HumbertoBM2/AnalogAndDigitalPID/DGallery/datoslimpios.png

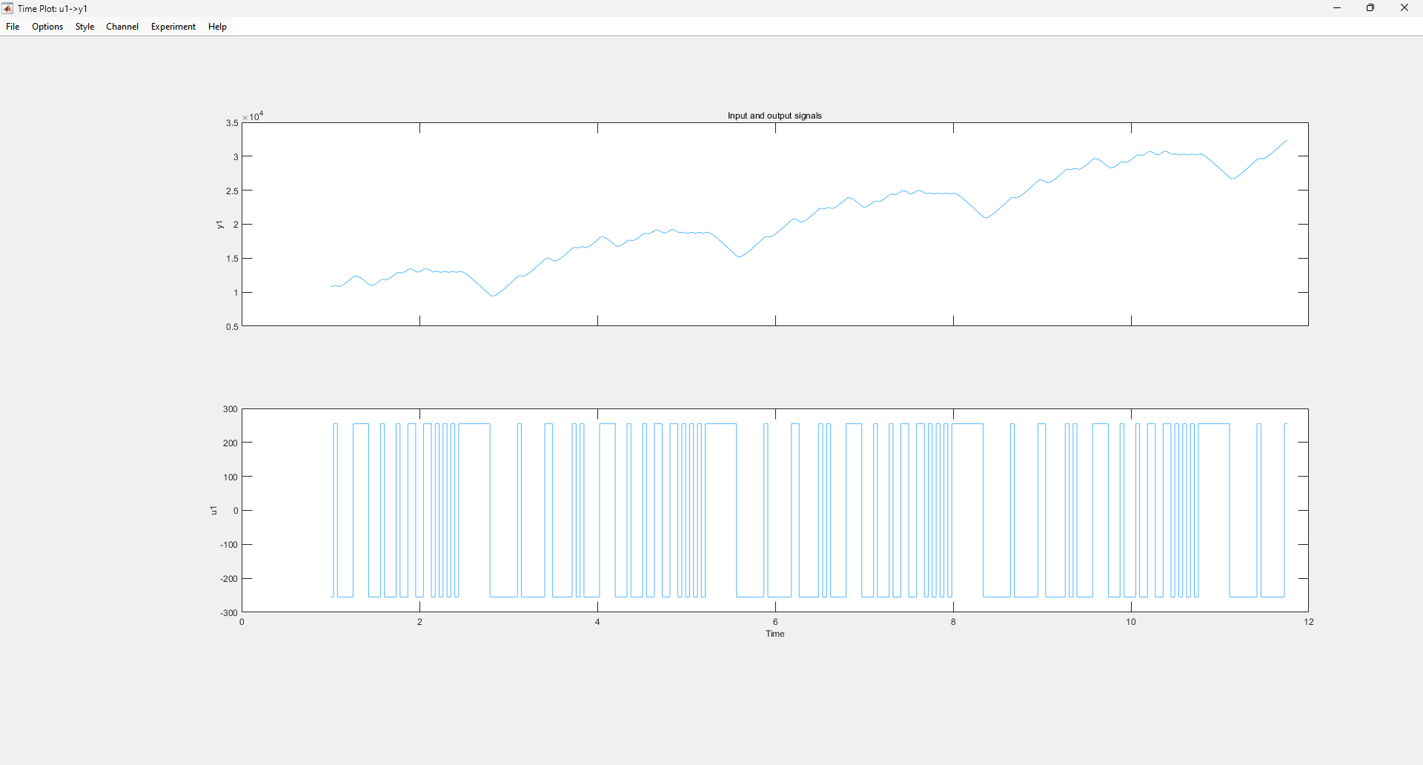
DGallery/datoslimpios.png
