HumbertoBM2/AnalogAndDigitalPID/DGallery/graficafsimulink.png

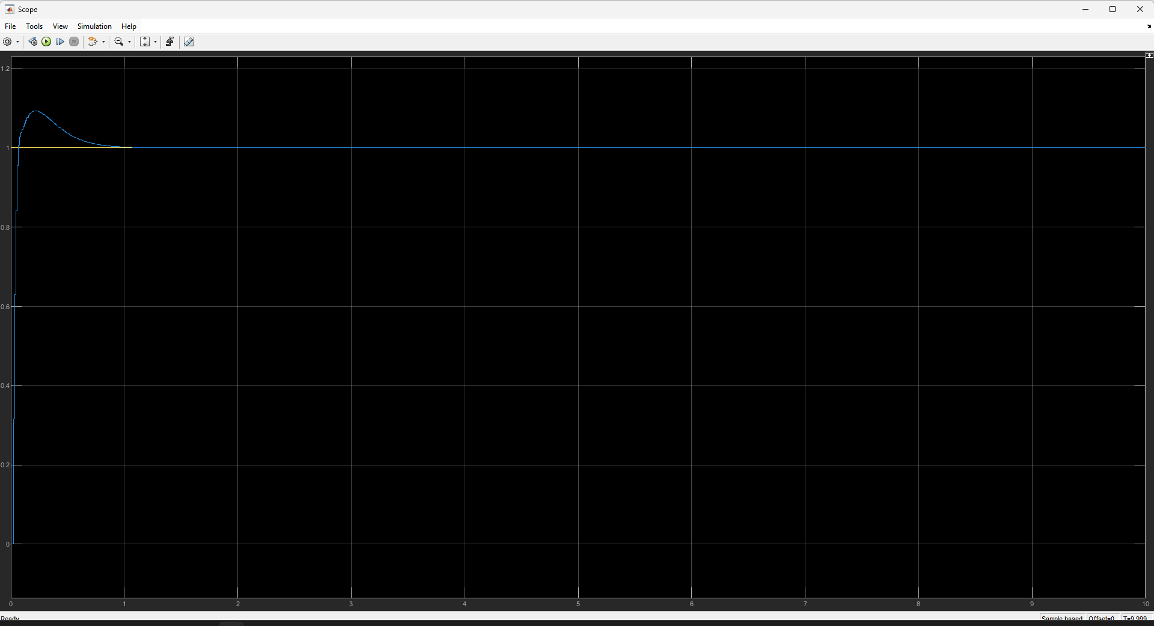
DGallery/graficafsimulink.png
