HumbertoBM2/AnalogAndDigitalPID/DGallery/pidsimulink.png

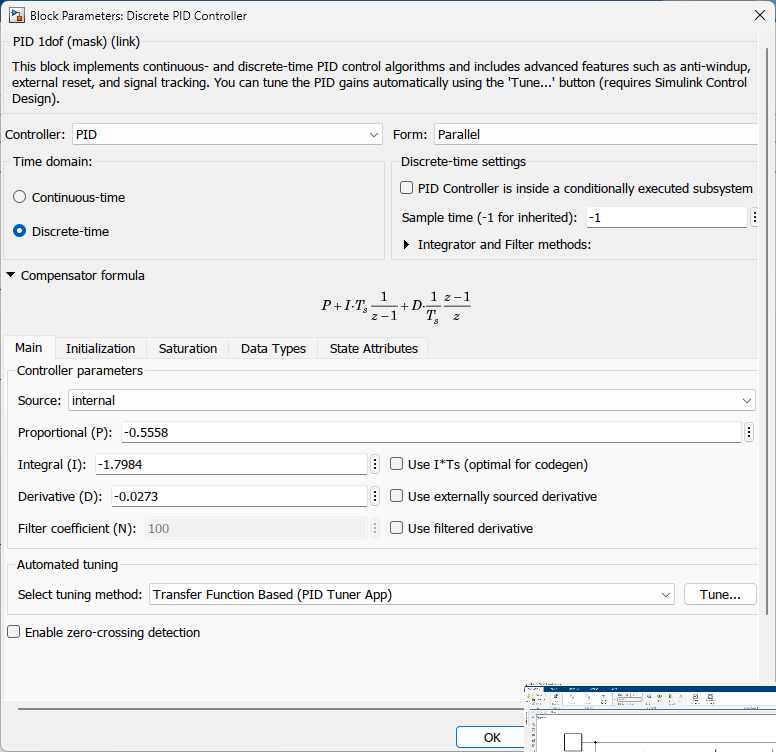
DGallery/pidsimulink.png
