HumbertoBM2/AnalogAndDigitalPID/DGallery/pitunerbueno.png

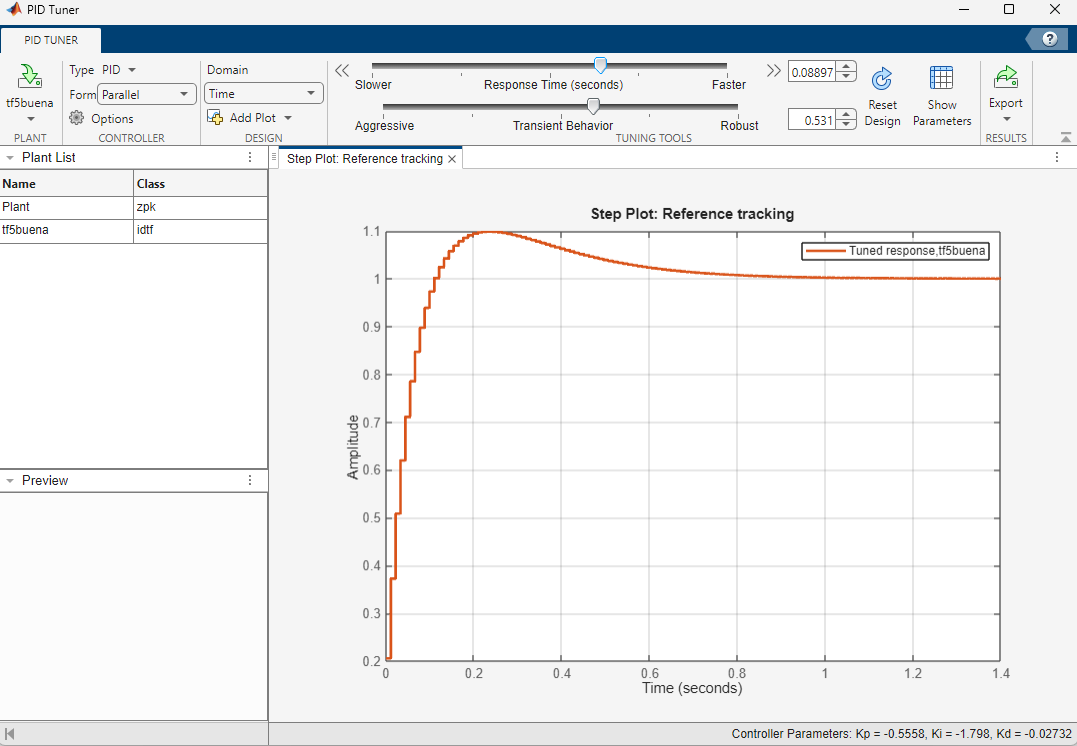
DGallery/pitunerbueno.png
