HumbertoBM2/AnalogAndDigitalPID/DGallery/ss1.jpg

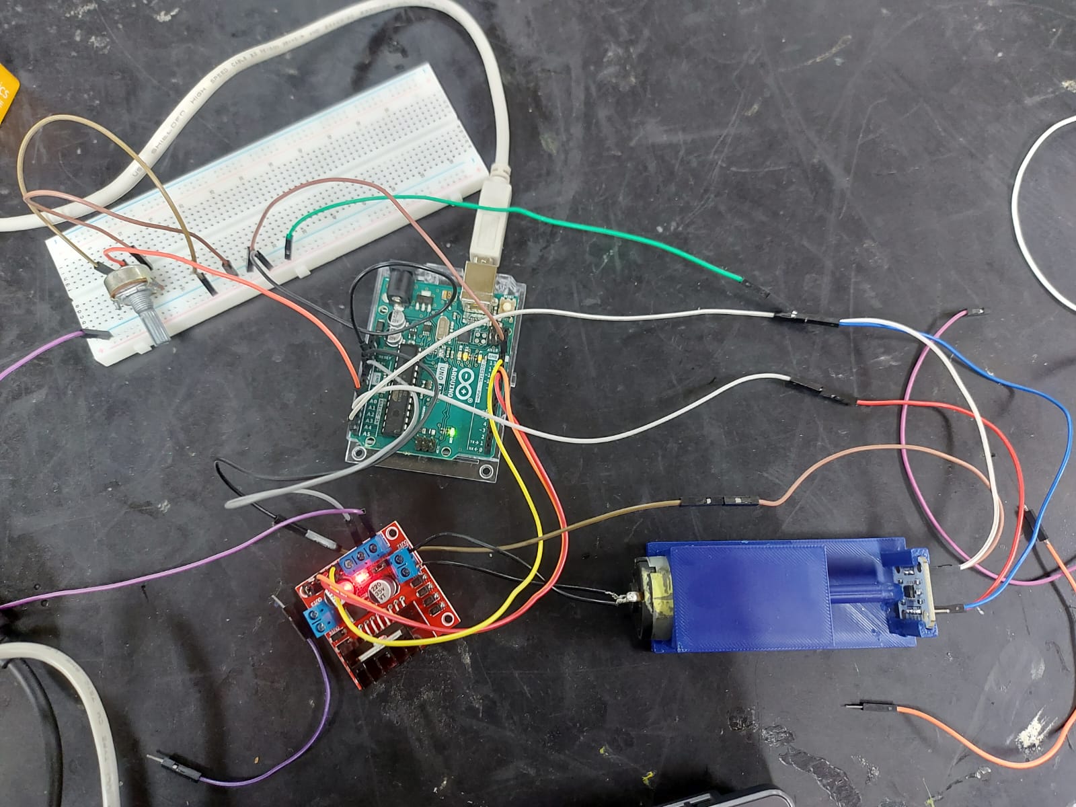
DGallery/ss1.jpg
