HumbertoBM2/AnalogAndDigitalPID/DGallery/ss2.jpg

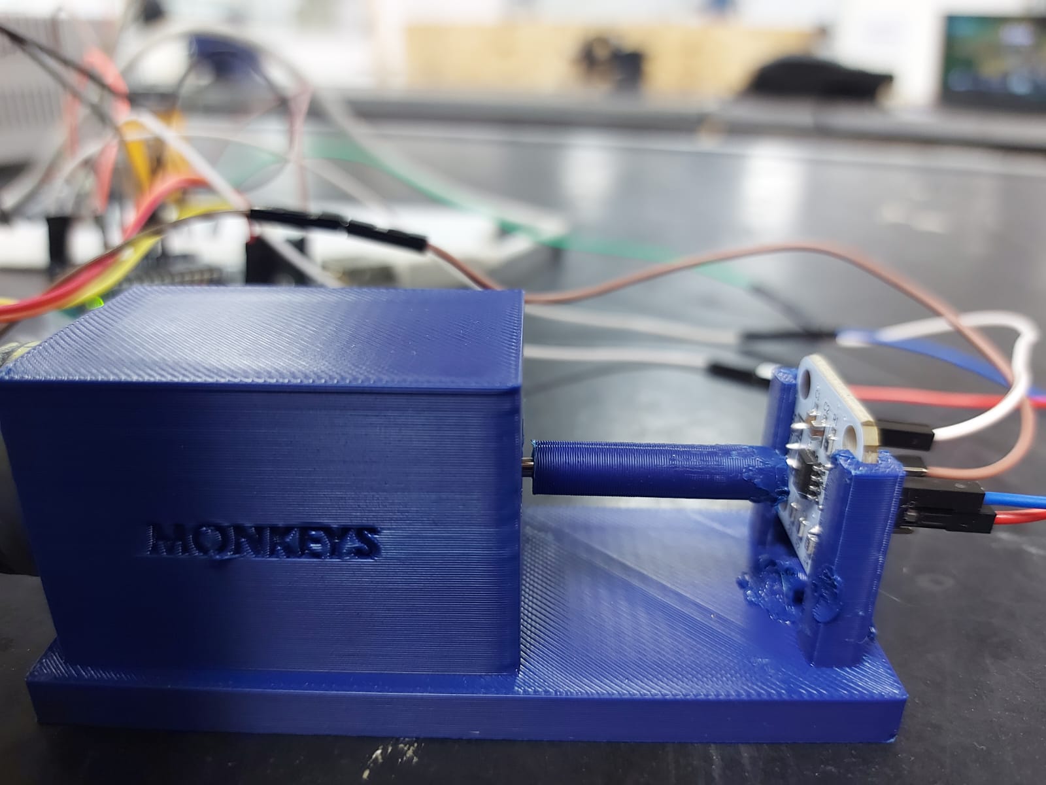
DGallery/ss2.jpg
