HumbertoBM2/AnalogAndDigitalPID/DGallery/ss3.png

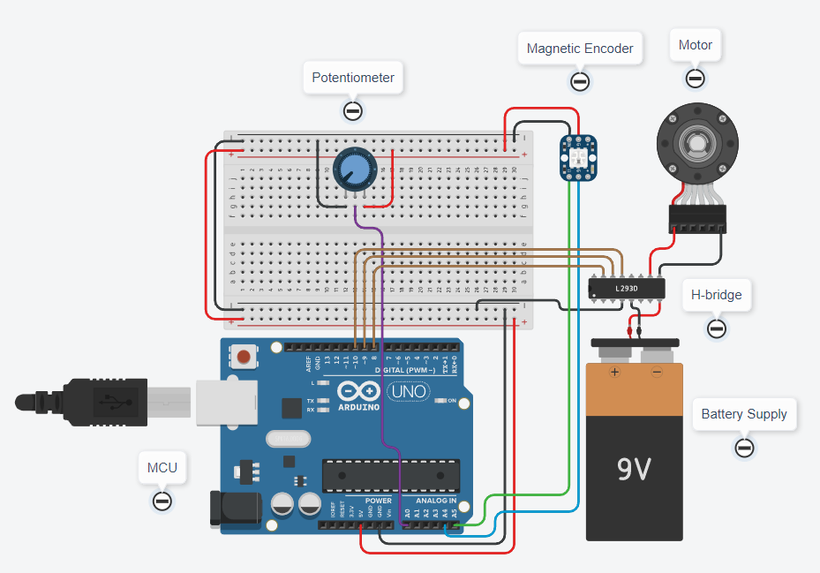
DGallery/ss3.png
