HumbertoBM2/AnalogAndDigitalPID/DGallery/ss11.jpg

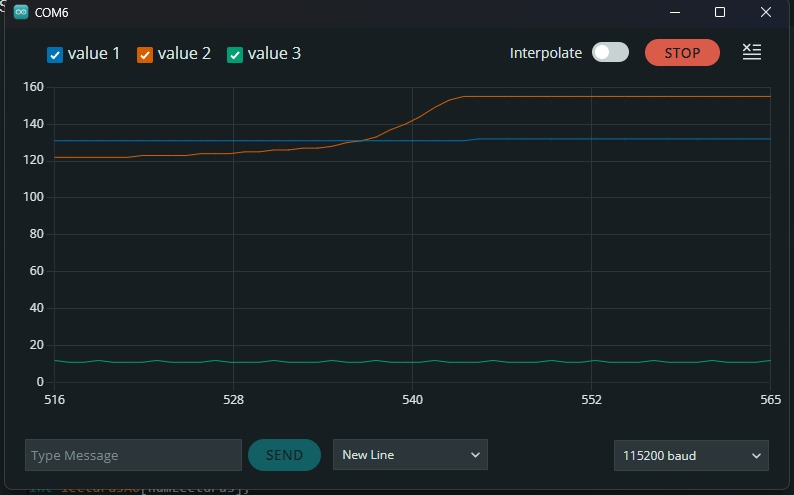
DGallery/ss11.jpg
