HumbertoBM2/AnalogAndDigitalPID/DGallery/systemident.png

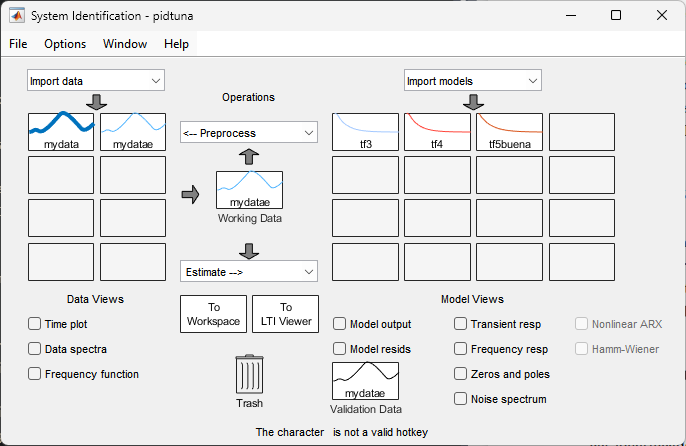
DGallery/systemident.png
