HumbertoBM2/AnalogAndDigitalPID/DGallery/tf5graf.png

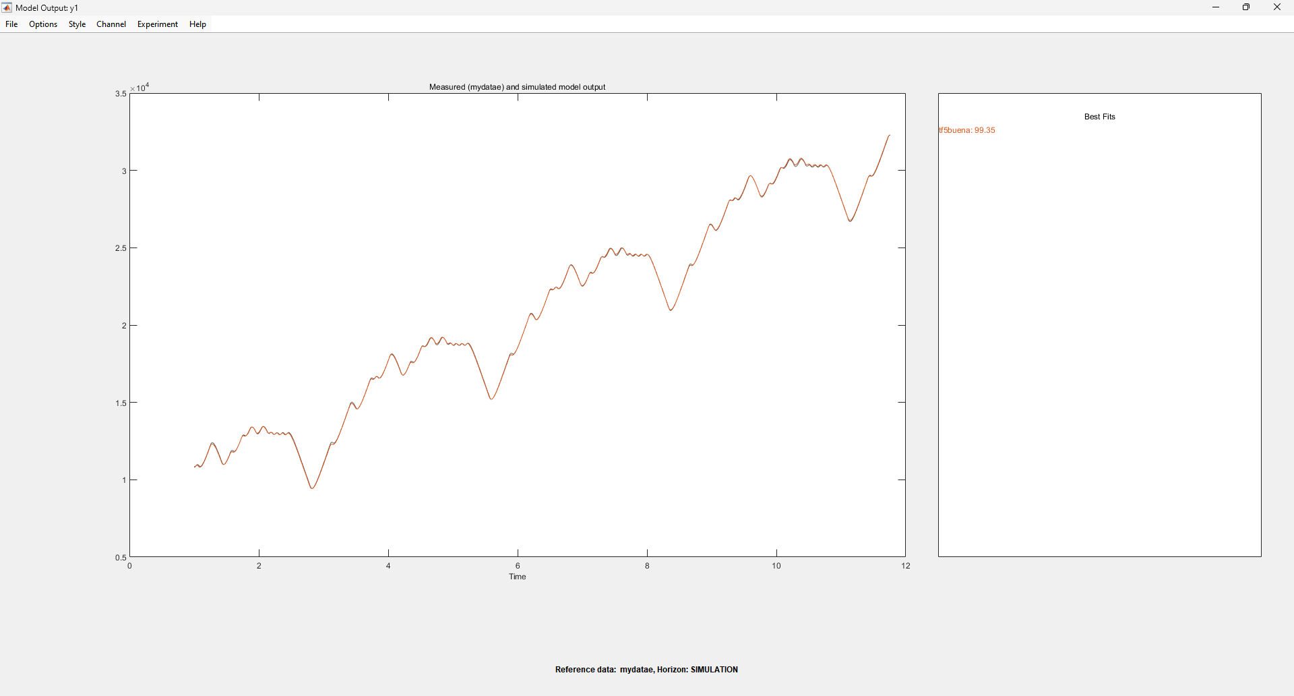
DGallery/tf5graf.png
