HumbertoBM2/AnalogAndDigitalPID/DGallery/setupsimulink.png

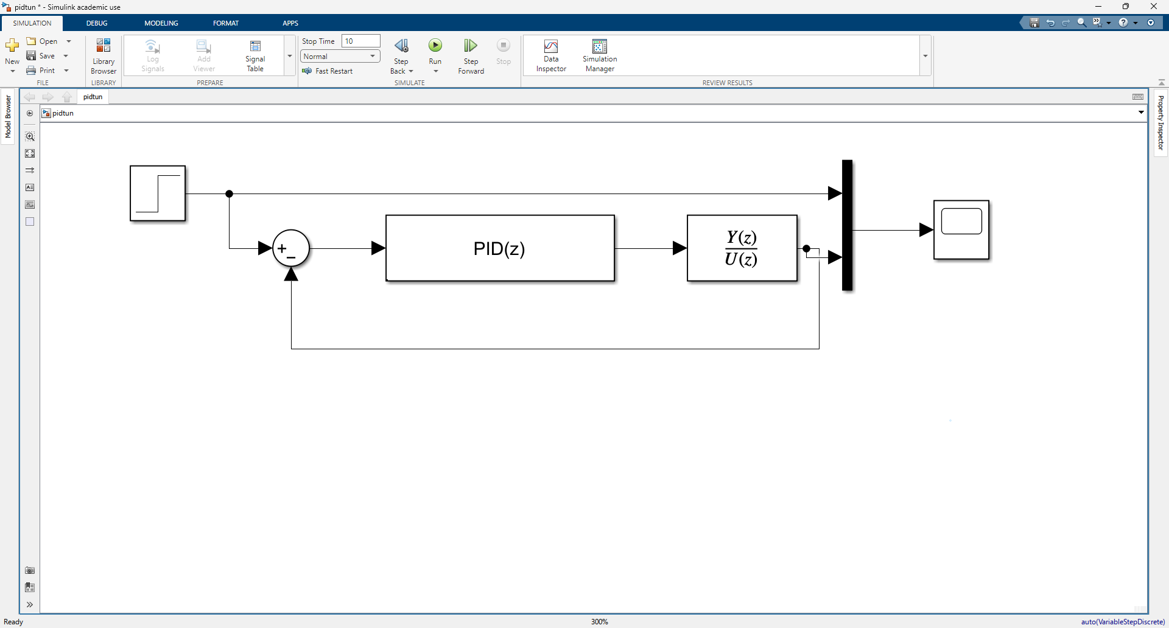
DGallery/setupsimulink.png
